denisgav/esp32_s3_weather_webserver/doc/ST7735S.png

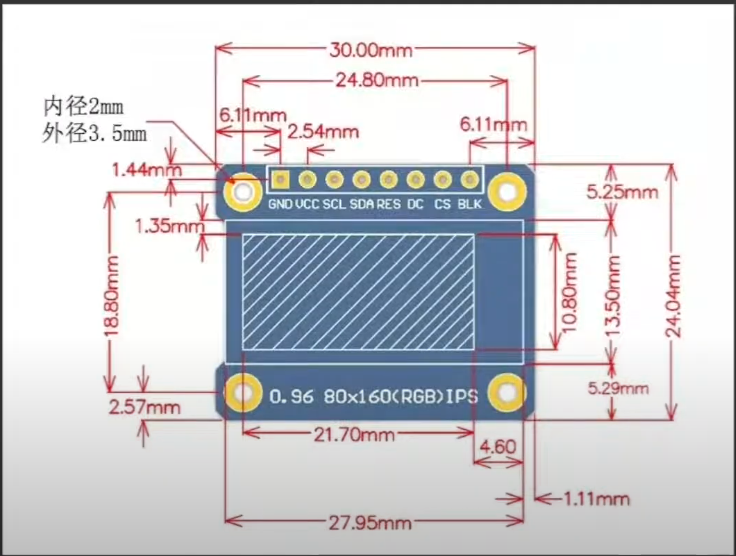
doc/ST7735S.png
