denisgav/esp32_s3_weather_webserver/doc/adafruit_products_VEML7700Q_sch.png

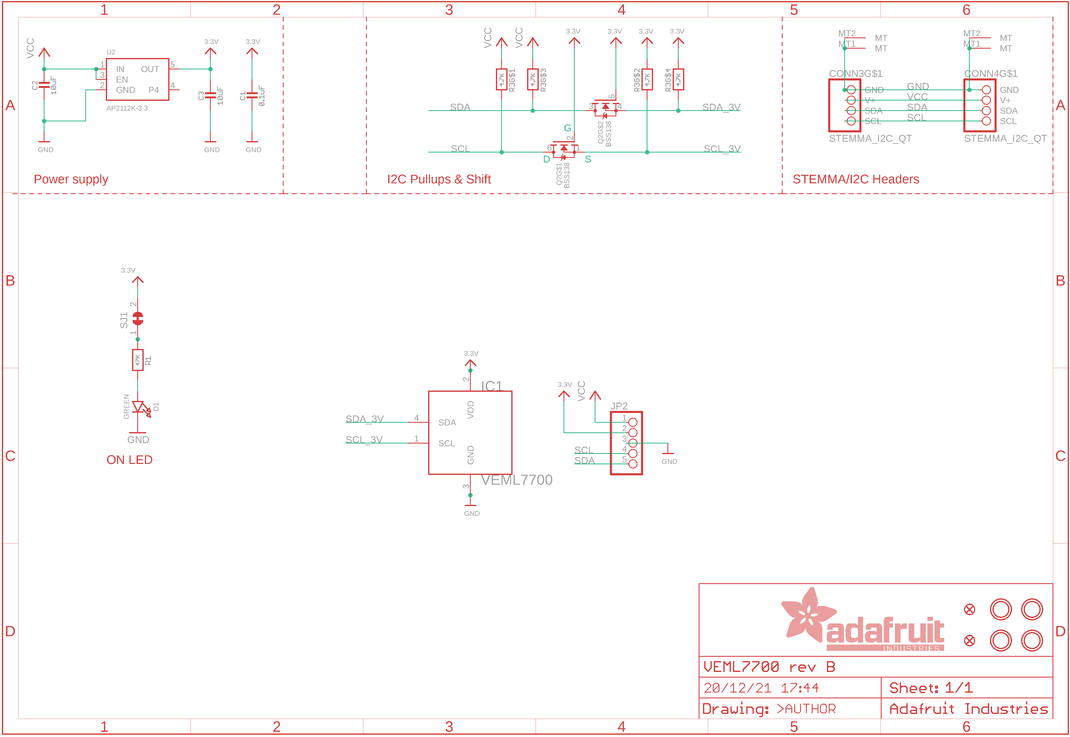
doc/adafruit_products_VEML7700Q_sch.png
