denisgav/esp32_s3_weather_webserver/doc/doc-upesy-esp32-power-path-circuit.webp

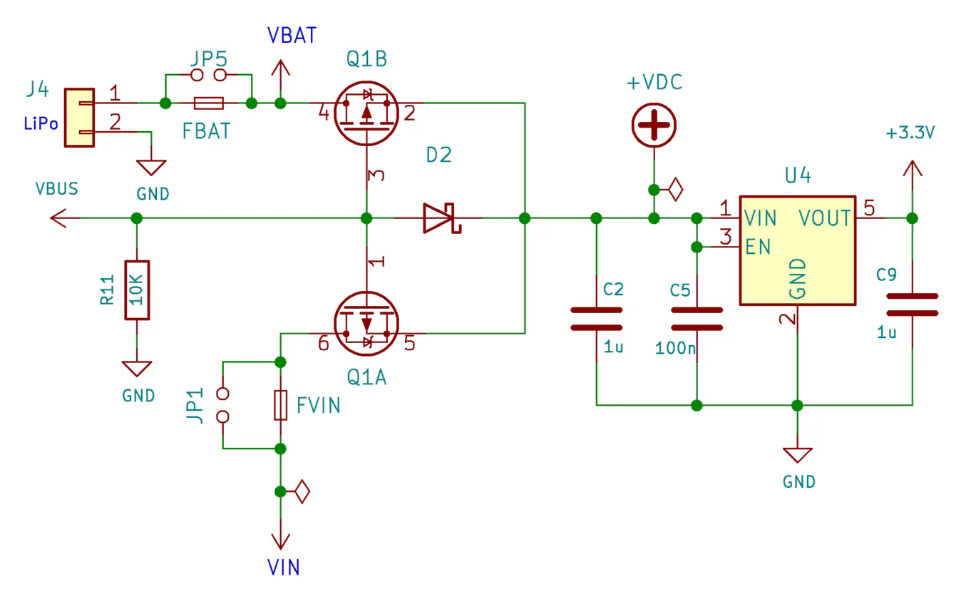
doc/doc-upesy-esp32-power-path-circuit.webp
