denisgav/esp32_s3_weather_webserver/KiCad/components/BC2032/BC2032-E2.step

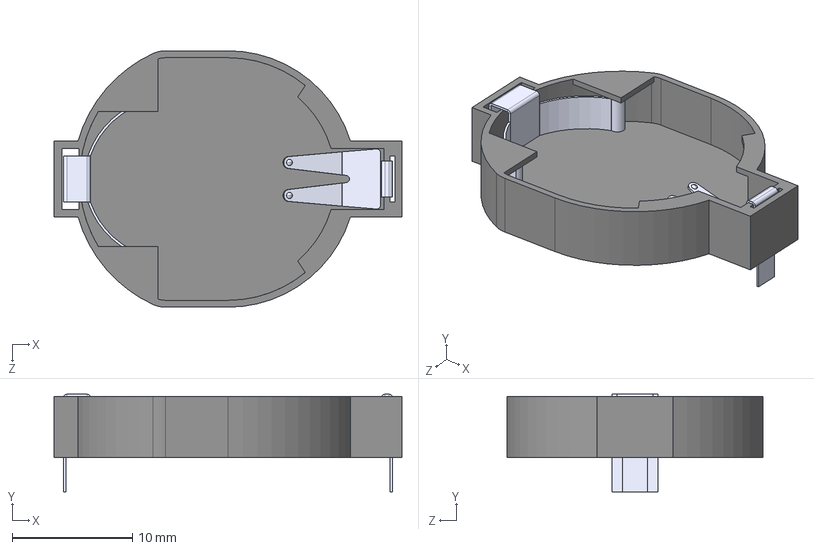
[picture p4: CAD file, 2025-09-14]
KiCad/components/BC2032/BC2032-E2.step
29.0 x 8.13 x 21.3 mm
