denisgav/esp32_s3_weather_webserver/KiCad/components/BM02B-GHS-TBT_LF__SN__N_/BM02B-GHS-TBT_LF__SN__N_.stp

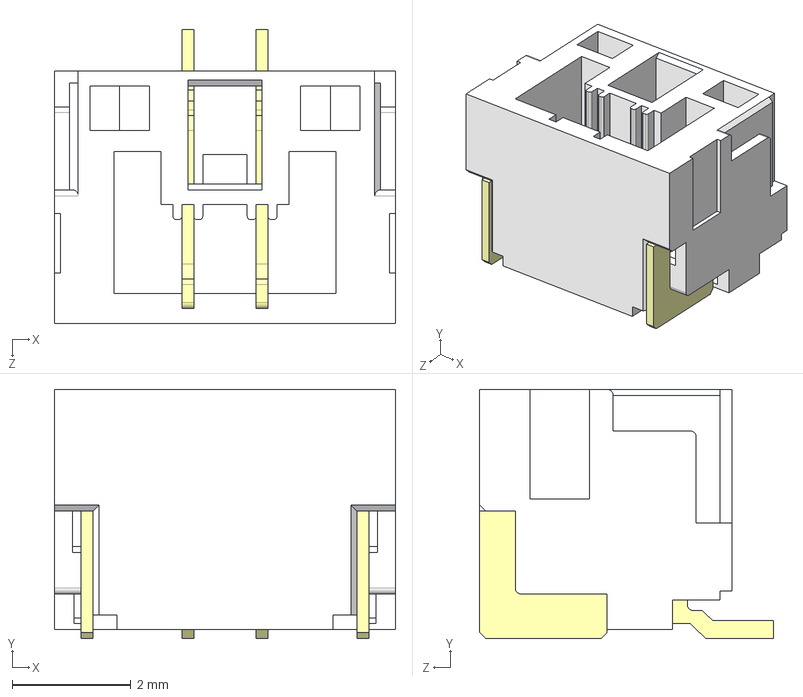
[picture p5: CAD file, 2025-09-20]
KiCad/components/BM02B-GHS-TBT_LF__SN__N_/BM02B-GHS-TBT_LF__SN__N_.stp
5.75 x 4.20 x 4.95 mm
