denisgav/esp32_s3_weather_webserver/KiCad/components/CP2102N-A02-GQFN28R/CP2102N-A02-GQFN28R.stp

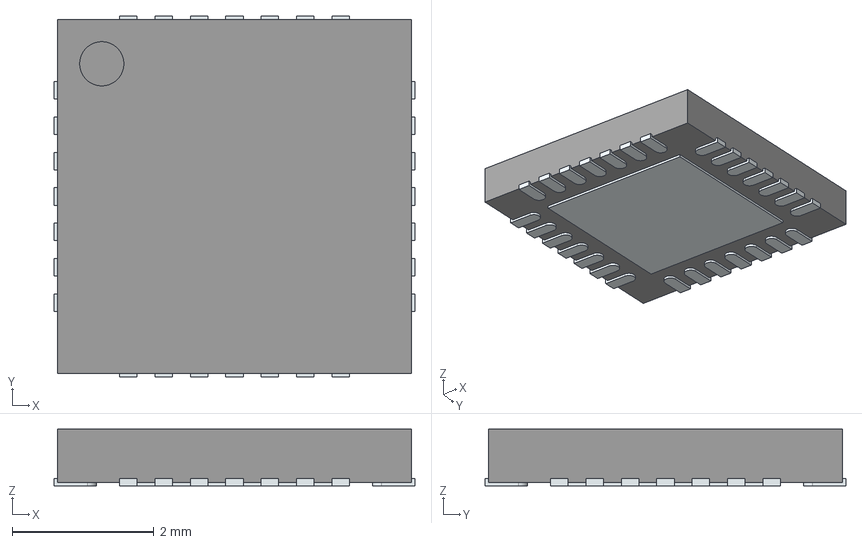
[picture p6: CAD file, 2025-09-05]
KiCad/components/CP2102N-A02-GQFN28R/CP2102N-A02-GQFN28R.stp
5.10 x 5.10 x 0.8 mm
ThermalPin
PinsArrayLR
PinsArrayTB
