denisgav/esp32_s3_weather_webserver/KiCad/components/CR1220-2/CR1220-2.stp

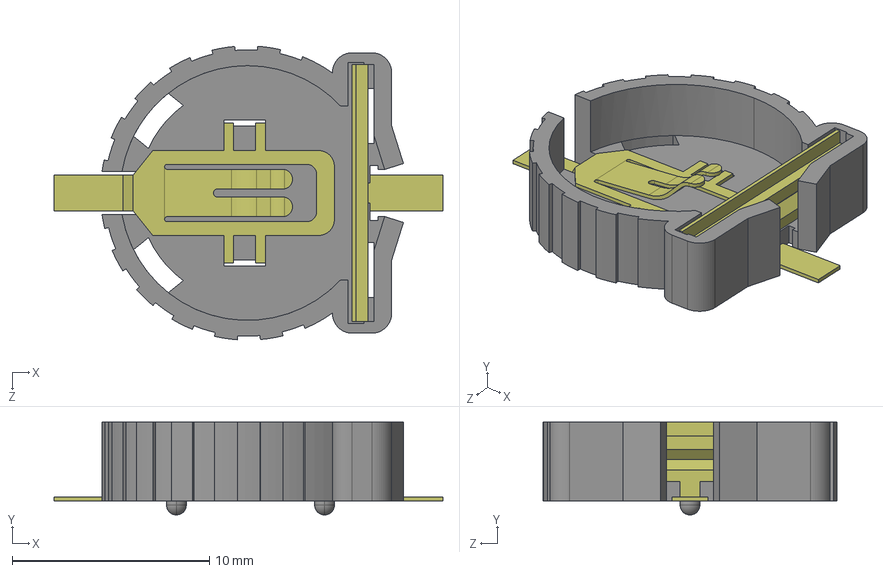
[picture p7: CAD file, 2025-09-06]
KiCad/components/CR1220-2/CR1220-2.stp
19.7 x 4.70 x 14.9 mm
