denisgav/esp32_s3_weather_webserver/KiCad/components/DS3231MZ+TRL/DS3231MZ+TRL.stp

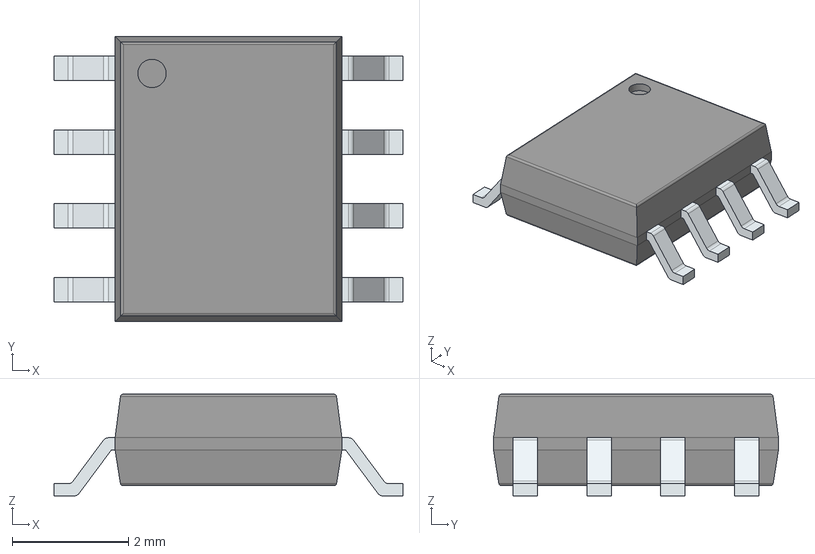
[picture p8: CAD file, 2025-09-06]
KiCad/components/DS3231MZ+TRL/DS3231MZ+TRL.stp
6.00 x 4.90 x 1.75 mm
PinsArrayLR
