denisgav/esp32_s3_weather_webserver/KiCad/components/ESP32-S3-WROOM-1-N16R8/ESP32-S3-WROOM-1-N16R8.stp

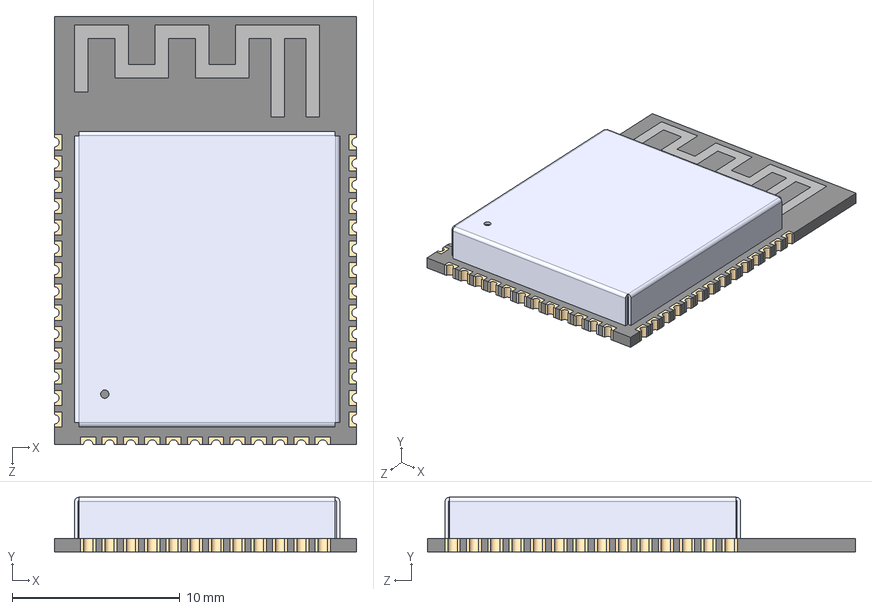
[picture p9: CAD file, 2025-09-05]
KiCad/components/ESP32-S3-WROOM-1-N16R8/ESP32-S3-WROOM-1-N16R8.stp
18.0 x 3.25 x 25.5 mm
