denisgav/esp32_s3_weather_webserver/KiCad/components/HRO  TYPE-C-31-M-12.step

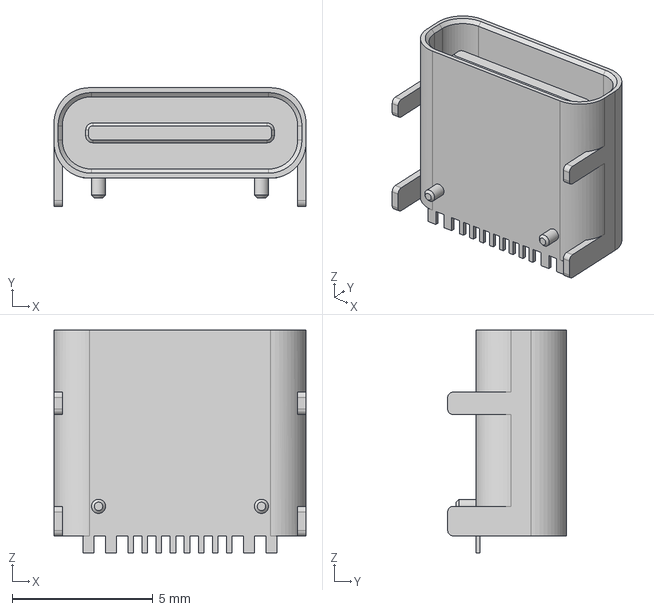
[picture p10: CAD file, 2025-09-13]
KiCad/components/HRO TYPE-C-31-M-12.step
8.94 x 4.21 x 7.90 mm
