denisgav/esp32_s3_weather_webserver/KiCad/components/SW_PUSH_6mm_H5mm/SW_PUSH_6mm_H5mm.step

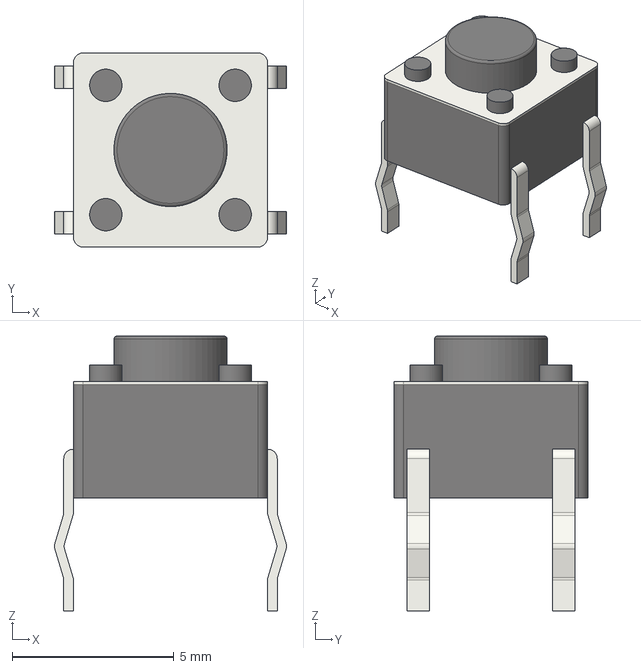
[picture p11: CAD file, 2025-09-06]
KiCad/components/SW_PUSH_6mm_H5mm/SW_PUSH_6mm_H5mm.step
7.17 x 6.00 x 8.50 mm
