denisgav/esp32_s3_weather_webserver/KiCad/components/TF-01A/TF-01A.stp

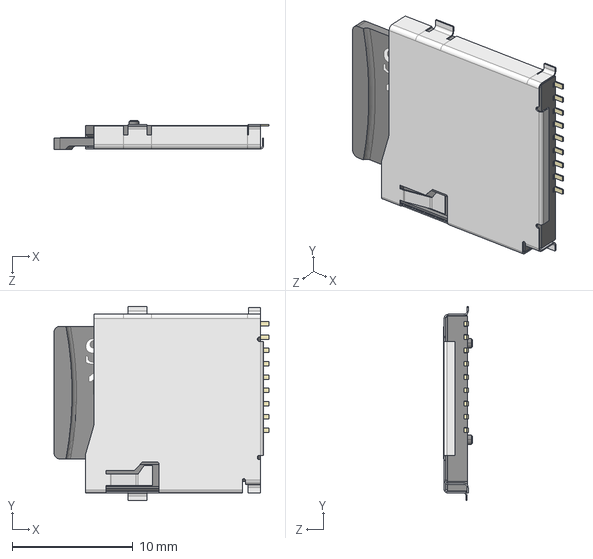
[picture p12: CAD file, 2025-09-06]
KiCad/components/TF-01A/TF-01A.stp
17.8 x 16.1 x 2.40 mm
