denisgav/esp32_s3_weather_webserver/KiCad/components/VEML7700-TT/VEML7700-TT.stp

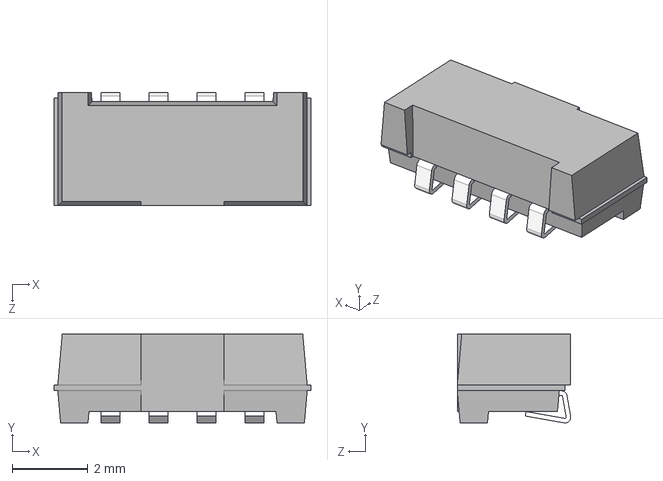
[picture p13: CAD file, 2025-09-07]
KiCad/components/VEML7700-TT/VEML7700-TT.stp
6.80 x 2.35 x 3.00 mm
