denisgav/esp32_s3_weather_webserver/KiCad/components/DHT11/DHT11.stp

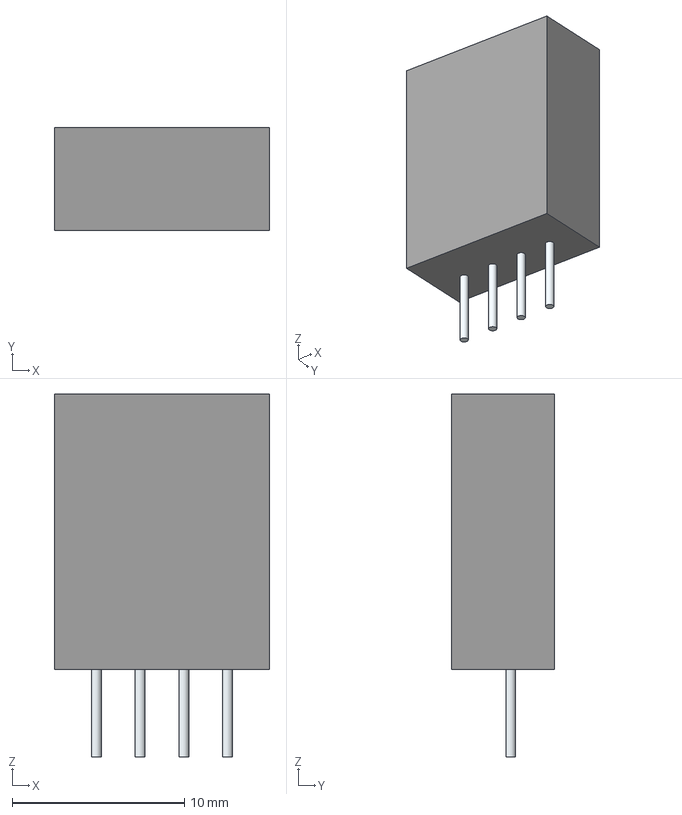
[picture p14: CAD file, 2025-09-07]
KiCad/components/DHT11/DHT11.stp
12.5 x 6.00 x 21.1 mm
Leads
