denisgav/esp32_s3_weather_webserver/KiCad/components/DHT11/101020011.stp

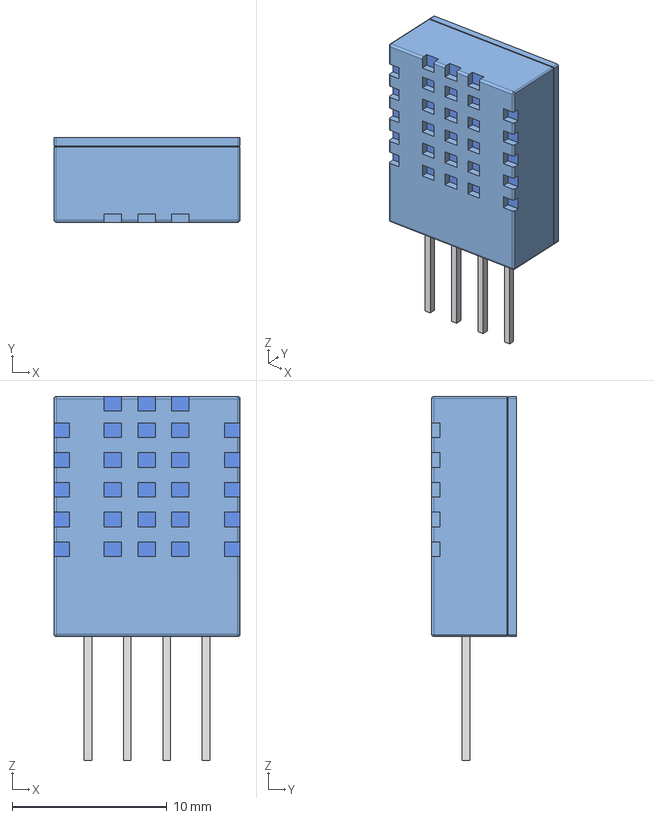
[picture p15: CAD file, 2025-09-07]
KiCad/components/DHT11/101020011.stp
12.0 x 5.50 x 23.5 mm
