denisgav/esp32_s3_weather_webserver/KiCad/components/MCP73831T-2ACI_OT/MCP73831T-2ACI_OT.stp

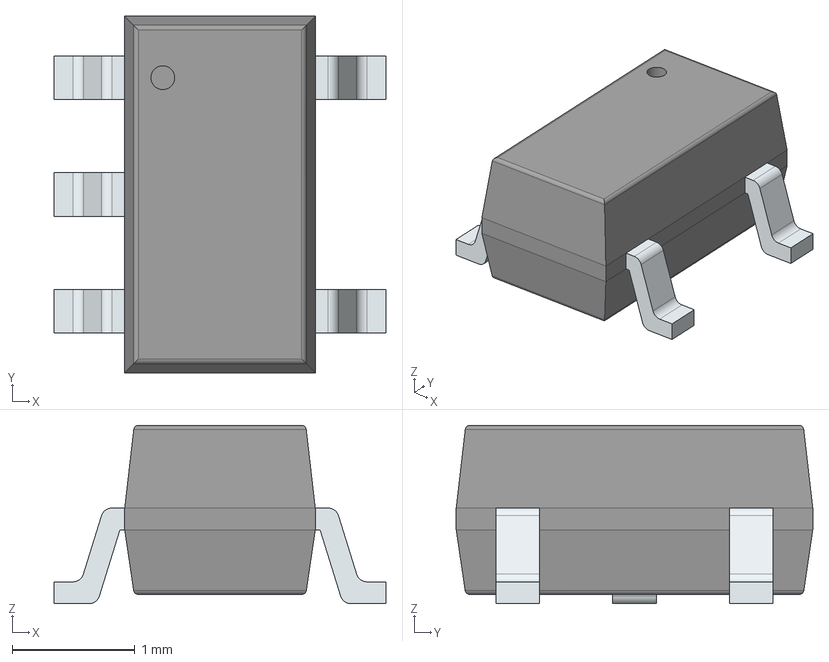
[picture p16: CAD file, 2025-09-20]
KiCad/components/MCP73831T-2ACI_OT/MCP73831T-2ACI_OT.stp
2.70 x 2.90 x 1.45 mm
PinsArrayL
PinsArrayR
