denisgav/esp32_s3_weather_webserver/KiCad/esp32_s3_weather_webserver.pdf

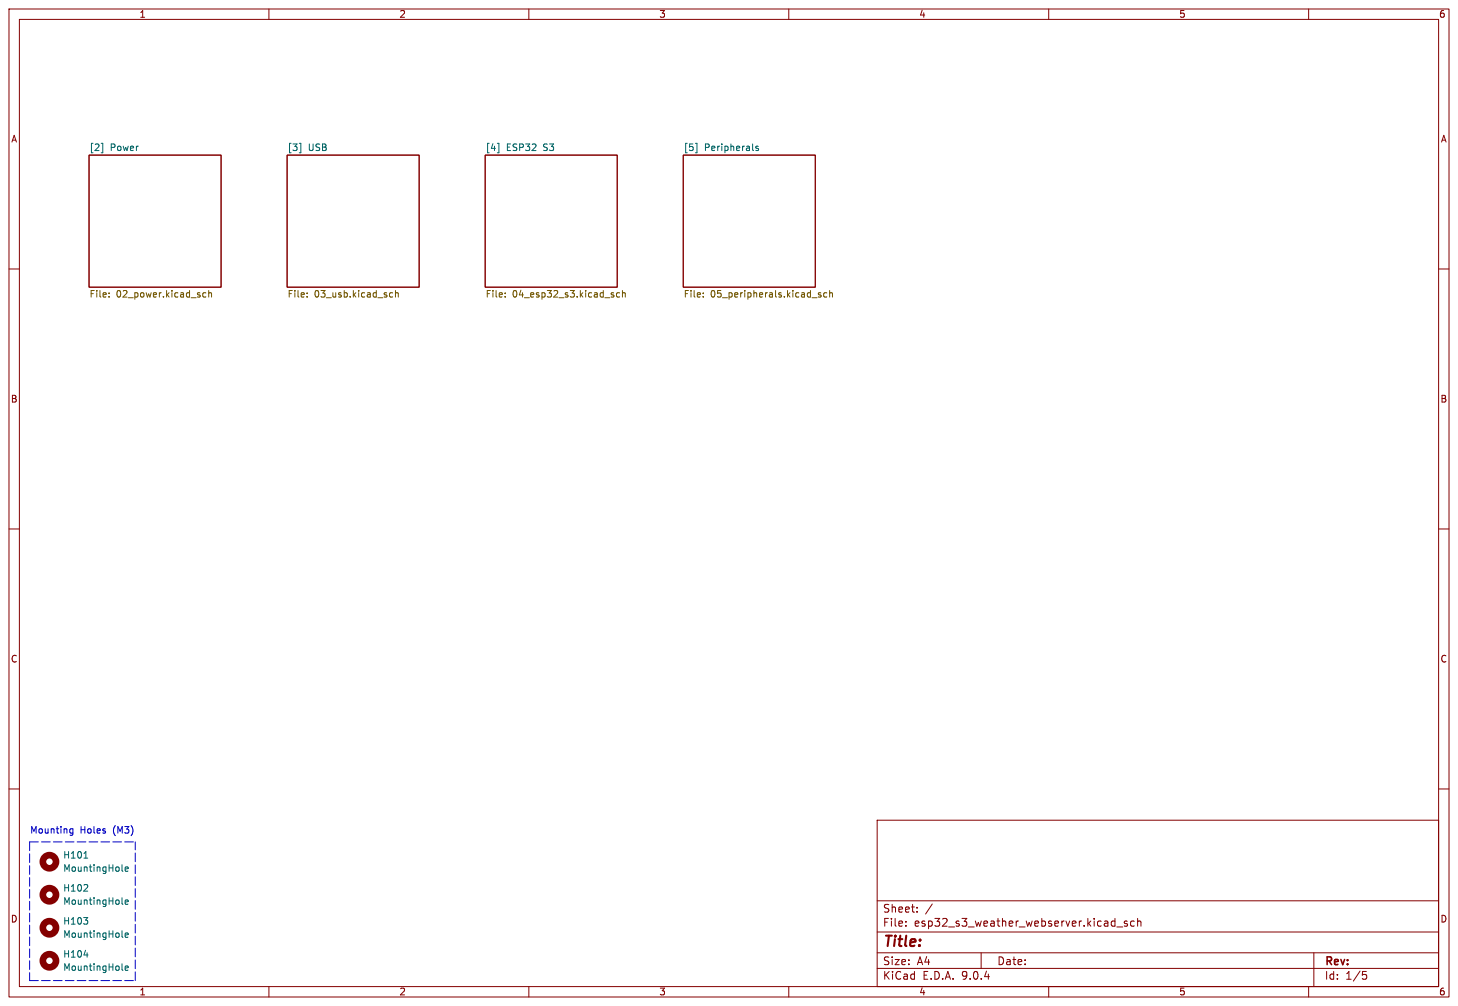
[picture p17: page 1]

[4] ESP32 S3 File: 04_esp32_s3.kicad_sch H102 MountingHole H104 MountingHole H101 MountingHole H103 MountingHole

Id: 1/5 Title: File: esp32_s3_weather_webserver.kicad_sch Sheet: /

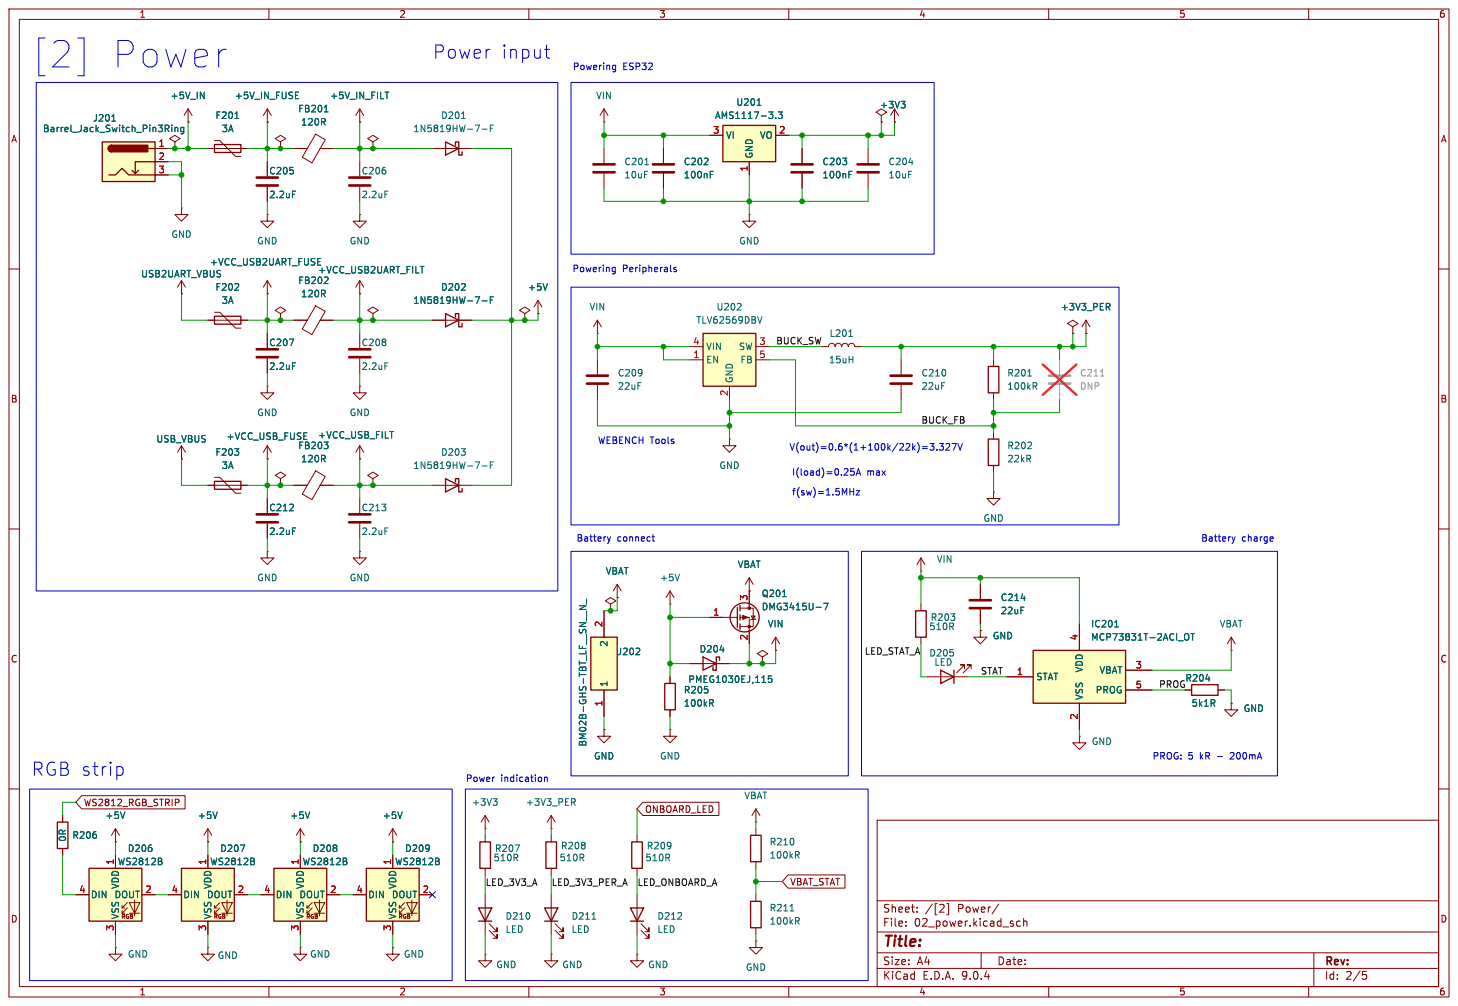
[picture p18: page 2]

100nF VIN
Battery connect Powering Peripherals

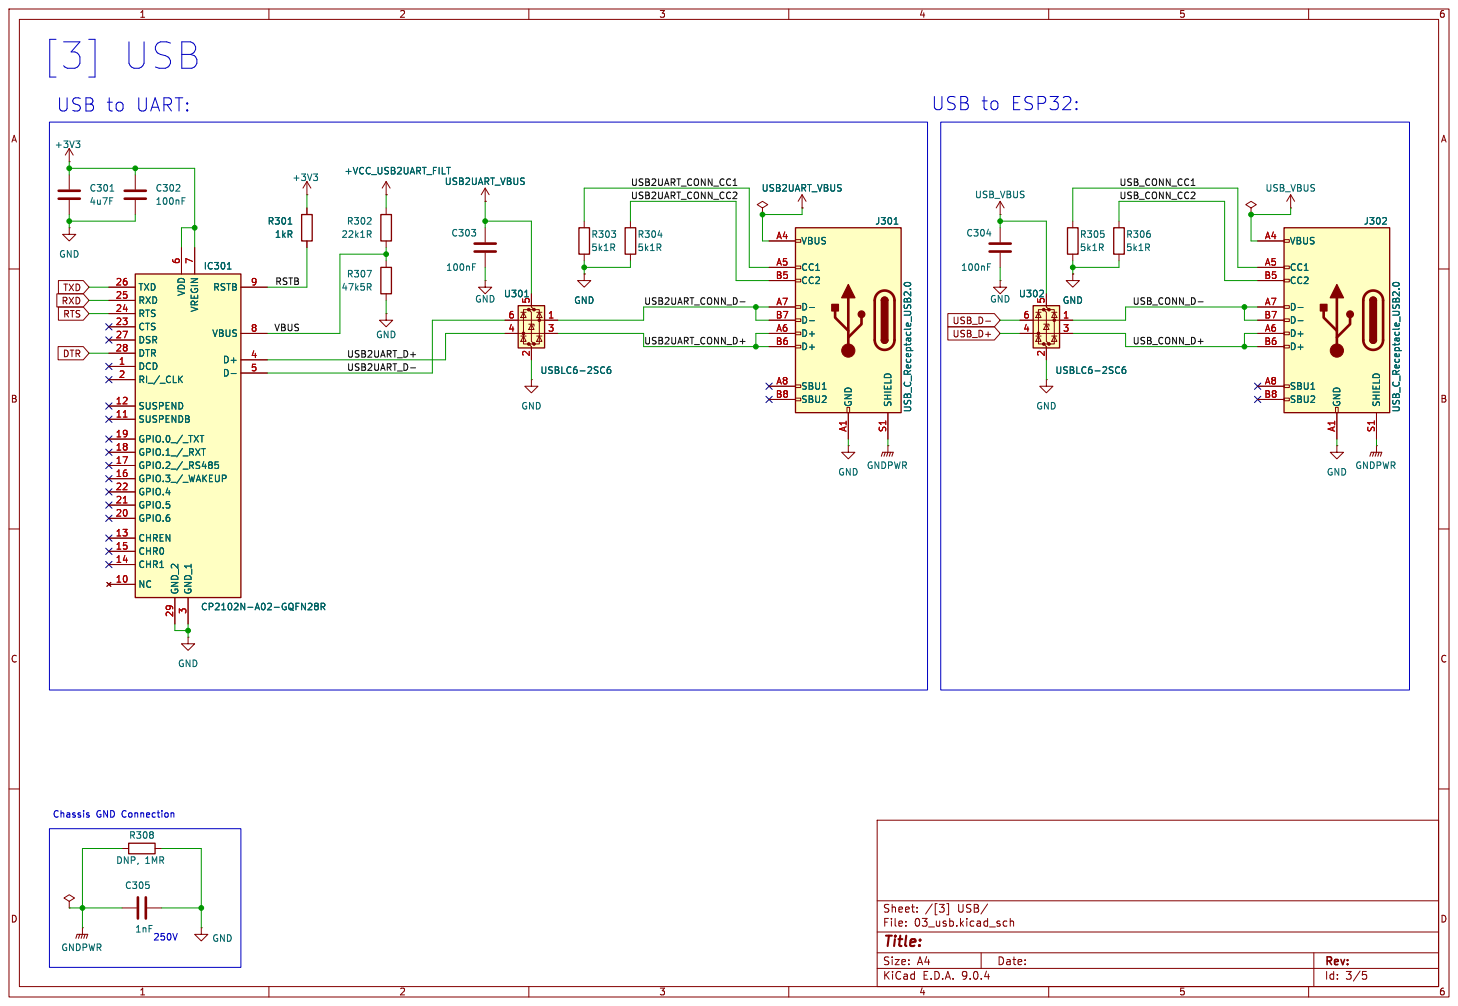
[picture p19: page 3]

6 GND_2 29 TXD 26 RXD 25 RTS 24 CTS 23 DSR 27 DTR 28 DCD 1 RI_/_CLK 2 SUSPEND 12 SUSPENDB 11 GPIO.0_/_TXT 19 GPIO.1_/_RXT 18 GPIO.2_/_RS485 17 GPIO.3_/_WAKEUP 16 GPIO.4 22 GPIO.5 21 GPIO.6 20 CHREN 13 CHR0 15 CHR1 14 NC 10 USB2UART_VBUS

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

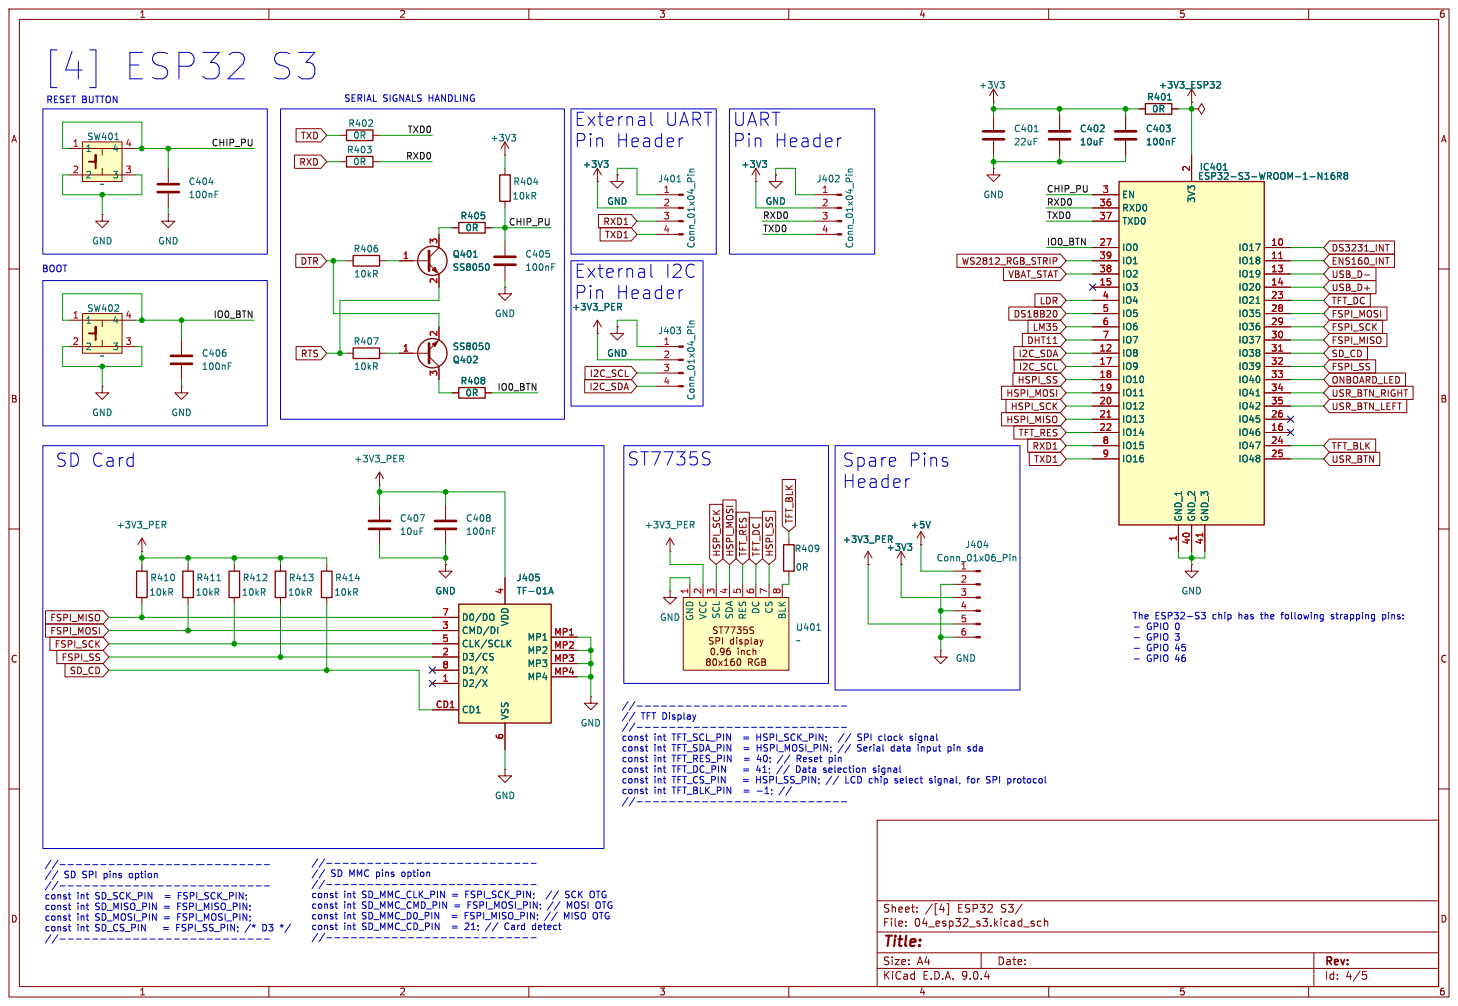
[picture p20: page 4]

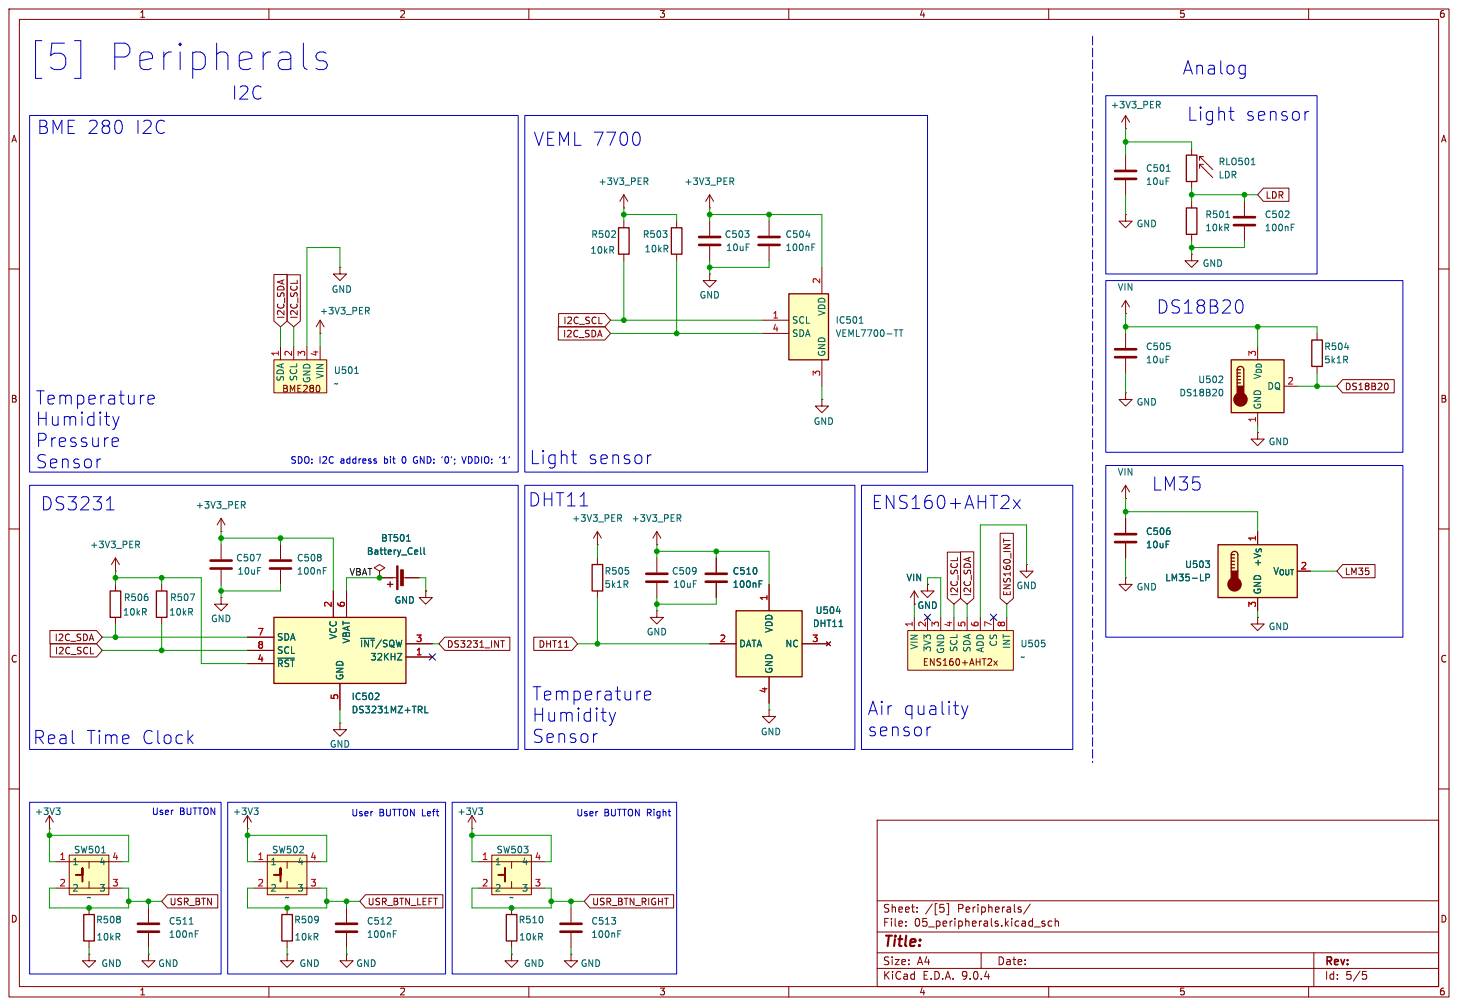
[picture p21: page 5]
