denisgav/esp32_s3_weather_webserver/KiCad/esp32_s3_weather_webserver.kicad_pcb

## KiCad design KiCad/esp32_s3_weather_webserver.kicad_pcb (2026-01-04)

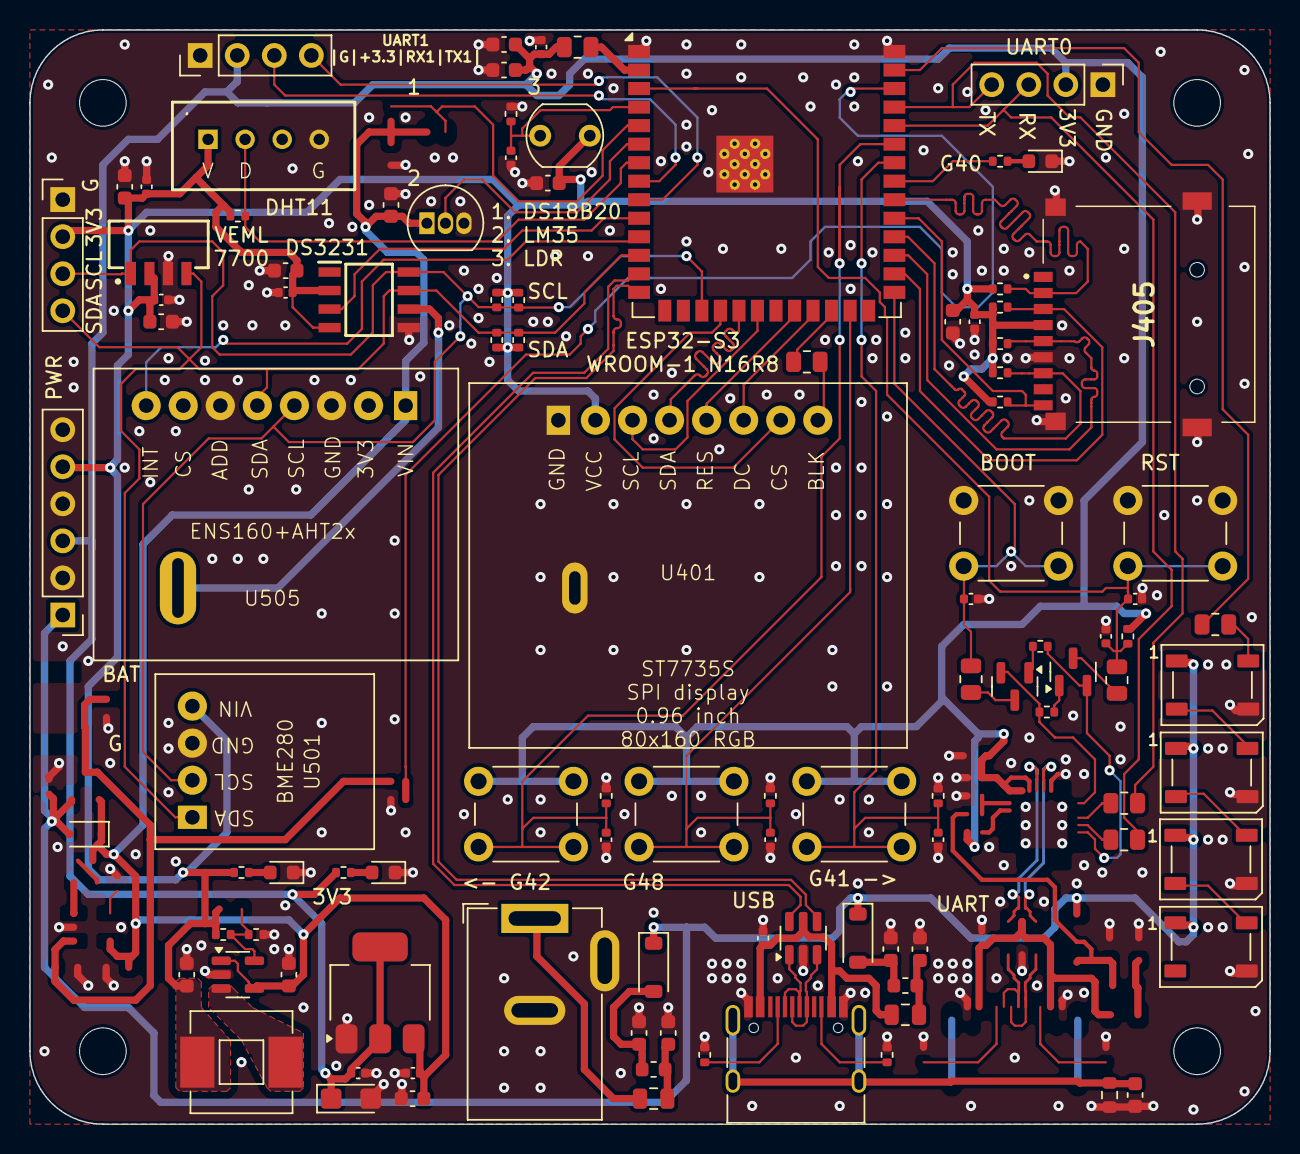
[picture p22: board esp32_s3_weather_webserver.kicad_pcb from above]

Board: 4 copper layers, 85.0 x 75.0 mm, 110 parts (1 on the bottom side), 65 nets.

Parts:
BT501: Battery_Cell; MPD_BC2032-E2
C201, C402, C407, C501, C503, C506, C507, C509: 10uF; C_0603_1608Metric
C202, C203, C304, C403, C404, C405, C406, C408, C502, C504, C508, C510, C511, C512, C513: 100nF; C_0402_1005Metric
C204: 22uF_P; CP_EIA-3216-18_Kemet-A
C205, C206, C212, C213: 2.2uF; C_0603_1608Metric
C209, C210, C401: 22uF; C_0603_1608Metric
C305: 1nF; C_0603_1608Metric
D201, D203: 1N5819HW-7-F; D_SOD-123
D204: PMEG1030EJ,115; D_SOD-323F
D206, D207, D208, D209: WS2812B; LED_WS2812B_PLCC4_5.0x5.0mm_P3.2mm
D210, D211, D212: LED; LED_0603_1608Metric
F201, F203: 3A; Fuse_0805_2012Metric
FB201, FB203: 120R; Fuse_0603_1608Metric
H101, H102, H103, H104: MountingHole; MountingHole_3.2mm_M3
IC401: ESP32-S3-WROOM-1-N16R8; ESP32S3WROOM1N16R8
IC501: VEML7700-TT; VEML7700
IC502: DS3231MZ+TRL; SOIC127P600X175-8N
J201: Barrel_Jack_Switch_Pin3Ring; BarrelJack_GCT_DCJ200-10-A_Horizontal
J302: USB_C_Receptacle_USB2.0; USB_C_Receptacle_HRO_TYPE-C-31-M-12
J401, J402, J403: Conn_01x04_Pin; PinHeader_1x04_P2.54mm_Vertical
J404: Conn_01x06_Pin; PinHeader_1x06_P2.54mm_Vertical
J405: TF-01A; TF01A
L201: 15uH; MWSA0603S
Q401, Q402: SS8050; SOT-23
R201: 100kR; R_0402_1005Metric
R202: 22kR; R_0402_1005Metric
R206, R401, R402, R403, R405, R408, R409: 0R; R_0805_2012Metric
R207, R208, R209: 510R; R_0402_1005Metric
R305, R306, R505: 5k1R; R_0402_1005Metric
R308: DNP, 1MR; R_0603_1608Metric
R404, R406, R407, R410, R411, R412, R413, R414, R501, R502, R503, R506, R507, R508, R509, R510: 10kR; R_0402_1005Metric
RLO501: LDR; R_LDR_5.1x4.3mm_P3.4mm_Vertical
SW401, SW402, SW501, SW502, SW503: SW_PUSH_6mm_H5mm
U201: AMS1117-3.3; SOT-223-3_TabPin2
U202: TLV62569DBV; SOT-23-5
U302: USBLC6-2SC6; SOT-23-6
U401: ST7735S
U501: BME280
U503: LM35-LP; TO-92_Inline
U504: DHT11
U505: ENS160+AHT2x

Connections:
+3V3: C203.1, C204.1, C401.1, C402.1, C403.1, J401.2, J402.2, J404.3, R207.2, R401.1, R404.2, SW501.1, SW501.4, SW502.1, SW502.4, SW503.1, SW503.4, U201.2 (VO)
+3V3_ESP32: IC401.2 (3V3), R401.2
+3V3_PER: C210.1, C407.1, C408.1, C501.1, C503.1, C504.1, C507.1, C508.1, C509.1, C510.1, IC501.2 (VDD), IC502.2 (VCC), IC502.4 (~RST), J403.2, J404.5, J405.4 (VDD), L201.2, R201.2, R208.2, R410.2, R411.2, R412.2, R413.2, R414.2, R502.2, R503.2, R505.1, R506.2, R507.2, RLO501.2, U401.2 (VCC), U501.4 (VIN), U504.1 (VDD)
+5V: D201.1 (K), D203.1 (K), D204.2 (A), D206.1 (VDD), D207.1 (VDD), D208.1 (VDD), D209.1 (VDD), J404.1
+5V_IN: F201.1, J201.1
+5V_IN_FILT: C206.1, D201.2 (A), FB201.1
+5V_IN_FUSE: C205.1, F201.2, FB201.2
+VCC_USB_FILT: C213.1, D203.2 (A), FB203.1
+VCC_USB_FUSE: C212.1, F203.2, FB203.2
/[2] Power/BUCK_FB: R201.1, R202.2, U202.5 (FB)
/[2] Power/BUCK_SW: L201.1, U202.3 (SW)
/[2] Power/LED_3V3_A: D210.2 (A), R207.1
/[2] Power/LED_3V3_PER_A: D211.2 (A), R208.1
/[2] Power/LED_ONBOARD_A: D212.2 (A), R209.1
/[3] USB/USB_CONN_CC1: J302.A5 (CC1), R305.1
/[3] USB/USB_CONN_CC2: J302.B5 (CC2), R306.1
/[3] USB/USB_CONN_D+: J302.A6 (D+), J302.B6 (D+), U302.3 (I/O2)
/[3] USB/USB_CONN_D-: J302.A7 (D-), J302.B7 (D-), U302.1 (I/O1)
/[4] ESP32 S3/CHIP_PU: C404.1, C405.1, IC401.3 (EN), R404.1, R405.2, SW401.1, SW401.4
/[4] ESP32 S3/IO0_BTN: C406.1, IC401.27 (IO0), R408.2, SW402.1, SW402.4
/[4] ESP32 S3/RXD0: IC401.36 (RXD0), J402.3, R403.2
/[4] ESP32 S3/TXD0: IC401.37 (TXD0), J402.4, R402.2
/[5] Peripherals/VBAT: BT501.1 (+), IC502.6 (VBAT)
DHT11: IC401.7 (IO7), R505.2, U504.2 (DATA)
DS3231_INT: IC401.10 (IO17), IC502.3 (~INT/SQW)
DTR: Q402.2 (E), R406.1
ENS160_INT: IC401.11 (IO18), U505.8 (INT)
FSPI_MISO: IC401.30 (IO37), J405.7 (D0/DO), R410.1
FSPI_MOSI: IC401.28 (IO35), J405.3 (CMD/DI), R411.1
FSPI_SCK: IC401.29 (IO36), J405.5 (CLK/SCLK), R412.1
FSPI_SS: IC401.32 (IO39), J405.2 (D3/CS), R413.1
GND: BT501.2 (-), C201.2, C202.2, C203.2, C204.2, C205.2, C206.2, C209.2, C210.2, C212.2, C213.2, C304.2, C305.2, C401.2, C402.2, C403.2, C404.2, C405.2, C406.2, C407.2, C408.2, C501.2, C502.2, C503.2, C504.2, C506.2, C507.2, C508.2, C509.2, C510.2, C511.2, C512.2, C513.2, D206.3 (VSS), D207.3 (VSS), D208.3 (VSS), D209.3 (VSS), D210.1 (K), D211.1 (K), D212.1 (K), IC401.1 (GND_1), IC401.40 (GND_2), IC401.41 (GND_3), IC501.3 (GND), IC502.5 (GND), J201.2, J201.3, J302.A1 (GND), J302.A12 (GND), J302.B1 (GND), J302.B12 (GND), J401.1, J402.1, J403.1, J404.2, J404.4, J404.6, J405.6 (VSS), J405.MP1, J405.MP2, J405.MP3, J405.MP4, R202.1, R305.2, R306.2, R308.2, R501.2, R508.1, R509.1, R510.1, SW401.2, SW401.3, SW402.2, SW402.3, U201.1 (GND), U202.2 (GND), U302.2 (GND), U401.1 (GND), U501.3 (GND), U503.3 (GND), U504.4 (GND), U505.3 (GND), U505.6 (ADD)
GNDPWR: C305.1, J302.S1 (SHIELD), R308.1
HSPI_MOSI: IC401.19 (IO11), U401.4 (SDA)
HSPI_SCK: IC401.20 (IO12), U401.3 (SCL)
HSPI_SS: IC401.18 (IO10), U401.7 (CS)
I2C_SCL: IC401.17 (IO9), IC501.1 (SCL), IC502.8 (SCL), J403.3, R502.1, R507.1, U501.2 (SCL), U505.4 (SCL)
I2C_SDA: IC401.12 (IO8), IC501.4 (SDA), IC502.7 (SDA), J403.4, R503.1, R506.1, U501.1 (SDA), U505.5 (SDA)
LDR: C502.1, IC401.4 (IO4), R501.1, RLO501.1
LM35: IC401.6 (IO6), U503.2 (V_{OUT})
unnamed: D206.4 (DIN), R206.1
unnamed: D206.2 (DOUT), D207.4 (DIN)
unnamed: D207.2 (DOUT), D208.4 (DIN)
unnamed: D208.2 (DOUT), D209.4 (DIN)
unnamed: Q401.1 (B), R406.2
unnamed: Q401.3 (C), R405.1
unnamed: Q402.1 (B), R407.2
unnamed: Q402.3 (C), R408.1
unnamed: R409.1, U401.8 (BLK)
ONBOARD_LED: IC401.33 (IO40), R209.2
RTS: Q401.2 (E), R407.1
RXD1: IC401.8 (IO15), J401.3
SD_CD: IC401.31 (IO38), J405.CD1, R414.1
TFT_BLK: IC401.24 (IO47), R409.2
TFT_DC: IC401.23 (IO21), U401.6 (DC)
TFT_RES: IC401.22 (IO14), U401.5 (RES)
TXD1: IC401.9 (IO16), J401.4
USB_D+: IC401.14 (IO20), U302.4 (I/O2)
USB_D-: IC401.13 (IO19), U302.6 (I/O1)
USB_VBUS: C304.1, F203.1, J302.A4 (VBUS), J302.A9 (VBUS), J302.B4 (VBUS), J302.B9 (VBUS), U302.5 (VBUS)
USR_BTN: C511.1, IC401.25 (IO48), R508.2, SW501.2, SW501.3
USR_BTN_LEFT: C512.1, IC401.35 (IO42), R509.2, SW502.2, SW502.3
USR_BTN_RIGHT: C513.1, IC401.34 (IO41), R510.2, SW503.2, SW503.3
VIN: C201.1, C202.1, C209.1, C506.1, D204.1 (K), U201.3 (VI), U202.1 (EN), U202.4 (VIN), U503.1 (+V_{S}), U505.1 (VIN)
WS2812_RGB_STRIP: IC401.39 (IO1), R206.2
