denisgav/esp32_s3_weather_webserver/Firmware/src/multisensor_wrapper.h

#pragma once

#include <Arduino.h>

#include "board_defines.h"

//-------------------------------------------------
// DS3231
//-------------------------------------------------
#include "DS3231_wrapper.h"
//-------------------------------------------------

//-------------------------------------------------
// BME280
//-------------------------------------------------
#include "BME280_wrapper.h"
//-------------------------------------------------

//-------------------------------------------------
// ENS160
//-------------------------------------------------
#include "ENS160_wrapper.h"
//-------------------------------------------------

//-------------------------------------------------
// AHT2x
//-------------------------------------------------
#include "AHT2x_wrapper.h"
//-------------------------------------------------

//-------------------------------------------------
// VEML7700
//-------------------------------------------------
#include "VEML7700_wrapper.h"
//-------------------------------------------------

//-------------------------------------------------
// DHT11
//-------------------------------------------------
#include "DHT11_wrapper.h"
//-------------------------------------------------

//-------------------------------------------------
// LM35
//-------------------------------------------------
#include "LM35_wrapper.h"
//-------------------------------------------------

//-------------------------------------------------
// DS18B20
//-------------------------------------------------
#include "DS18B20_wrapper.h"
//-------------------------------------------------

//-------------------------------------------------
// LDR
//-------------------------------------------------
#include "LDR_wrapper.h"
//-------------------------------------------------


class multisensor_wrapper{
public:
    // Class constructor
    multisensor_wrapper();
    // Initialize BME sensor
    bool init();
    // Sample date/time
    bool sample_sensor_data();

    // RTC3231
    DS3231_wrapper& get_rtc();
    // BME280
    BME280_wrapper& get_bme280();
    // ENS160
    ENS160_wrapper& get_ens160();
    // AHT2x
    AHT2x_wrapper& get_aht2x();
    // VEML7700
    VEML7700_wrapper& get_veml7700();
    // DHT11
    DHT11_wrapper& get_dht11();
    // LM35
    LM35_wrapper& get_lm35();
    // DS18B20
    DS18B20_wrapper& get_ds18b20();
    // LDR
    LDR_wrapper& get_ldr();

    // Print sampled values to serial
    void print_to_serial() const;

    bool get_is_initialized() const;
private:
    // RTC3231
    DS3231_wrapper rtc;

    // BME280
    BME280_wrapper bme280;

    // ENS160
    ENS160_wrapper ens160;

    // AHT2x
    AHT2x_wrapper aht2x;

    // VEML7700
    VEML7700_wrapper veml7700;

    // DHT11
    DHT11_wrapper dht11;

    // LM35
    LM35_wrapper lm35;

    // DS18B20
    DS18B20_wrapper ds18b20;

    // LDR
    LDR_wrapper ldr;
    
    bool is_initialized;
};
