denisgav/esp32_s3_weather_webserver/(commit log)

2025-08-30 Non operational web server
    [huge_app.csv.csv]
2025-09-05 Add KiCad project
    [ESP32-S3-WROOM-1-N16R8.stp, esp32_s3_weather_webserver.kicad_pcb, esp32_s3_weather_webserver.kicad_sch, huge_app.csv.csv]
2025-09-05 USB scheme
    [02_power.kicad_sch, 03_usb.kicad_sch, 04_esp32_s3.kicad_sch, 05_peripherals.kicad_sch, CP2102N-A02-GQFN28R.stp, esp32_s3_weather_webserver.kicad_sch]
2025-09-05 Update power scheme
    [02_power.kicad_sch, 04_esp32_s3.kicad_sch]
2025-09-06 Update ESP32 Scheme
    [04_esp32_s3.kicad_sch, SW_PUSH_6mm_H5mm.step]
2025-09-06 Add SD card to scheme
    [04_esp32_s3.kicad_sch, 05_peripherals.kicad_sch, TF-01A.stp]
2025-09-06 Add BME280
    [05_peripherals.kicad_sch]
2025-09-06 Add DS3231
    [03_usb.kicad_sch, 04_esp32_s3.kicad_sch, 05_peripherals.kicad_sch, CR1220-2.stp, DS3231MZ+TRL.stp]
2025-09-06 Add analog sensors
    [02_power.kicad_sch, 03_usb.kicad_sch, 04_esp32_s3.kicad_sch, 05_peripherals.kicad_sch]
2025-09-07 First scheme version
    [02_power.kicad_sch, 03_usb.kicad_sch, 04_esp32_s3.kicad_sch, 05_peripherals.kicad_sch, 101020011.stp, DHT11.stp, VEML7700-TT.stp]
2025-09-08 Firmware refactoring. Beginning
    [02_power.kicad_sch, 04_esp32_s3.kicad_sch, 05_peripherals.kicad_sch, esp32_s3_weather_webserver.kicad_pcb]
2025-09-09 Update BME280 Scheme, Add more sensors to firmware
    [04_esp32_s3.kicad_sch, 05_peripherals.kicad_sch]
2025-09-09 Add UART pin header
    [03_usb.kicad_sch, 04_esp32_s3.kicad_sch]
2025-09-09 Add multisensor wrapper
    [05_peripherals.kicad_sch, esp32_s3_weather_webserver.kicad_pcb]
2025-09-10 all sensors on web page
2025-09-11 Remove 3V3A power chain
    [02_power.kicad_sch, 05_peripherals.kicad_sch]
2025-09-11 Add sensor footprints
    [04_esp32_s3.kicad_sch, 05_peripherals.kicad_sch, esp32_s3_weather_webserver.kicad_pcb]
2025-09-11 BOM updates
    [02_power.kicad_sch, 03_usb.kicad_sch, 04_esp32_s3.kicad_sch, 05_peripherals.kicad_sch, esp32_s3_weather_webserver.kicad_pcb, esp32_s3_weather_webserver.kicad_sch]
2025-09-12 BOM updates. First layout
    [02_power.kicad_sch, 03_usb.kicad_sch, 04_esp32_s3.kicad_sch, 05_peripherals.kicad_sch, esp32_s3_weather_webserver.kicad_pcb, esp32_s3_weather_webserver.kicad_sch]
2025-09-12 Layout updates
    [05_peripherals.kicad_sch, esp32_s3_weather_webserver.kicad_pcb]
2025-09-13 PCB layout updates
    [04_esp32_s3.kicad_sch, esp32_s3_weather_webserver.kicad_pcb]
2025-09-13 PCB layout improvements
    [HRO TYPE-C-31-M-12.step, esp32_s3_weather_webserver.kicad_pcb]
2025-09-14 Simple routing
    [04_esp32_s3.kicad_sch, esp32_s3_weather_webserver.kicad_pcb]
2025-09-14 SPI signals routing
    [04_esp32_s3.kicad_sch, 05_peripherals.kicad_sch, BC2032-E2.step, esp32_s3_weather_webserver.kicad_pcb]
2025-09-15 Simple signal routing
    [04_esp32_s3.kicad_sch, esp32_s3_weather_webserver.kicad_pcb]
2025-09-16 Signals routing
    [esp32_s3_weather_webserver.kicad_pcb]
2025-09-16 Signal routing
    [05_peripherals.kicad_sch, esp32_s3_weather_webserver.kicad_pcb]
2025-09-16 Fix USB signal routing
    [esp32_s3_weather_webserver.kicad_pcb]
2025-09-18 Fix DRC
    [04_esp32_s3.kicad_sch, esp32_s3_weather_webserver.kicad_pcb]
2025-09-18 Temperature sensor placement update
    [esp32_s3_weather_webserver.kicad_pcb]
2025-09-18 Silk Screen updates
    [esp32_s3_weather_webserver.kicad_pcb]
2025-09-18 Update pin defines
2025-09-20 Add battery connector and charger
    [02_power.kicad_sch, 04_esp32_s3.kicad_sch, 05_peripherals.kicad_sch, BM02B-GHS-TBT_LF__SN__N_.stp, MCP73831T-2ACI_OT.stp, esp32_s3_weather_webserver.kicad_pcb]
2025-09-20 Connect VBAT to ADC input to measure battery voltage
    [02_power.kicad_sch, 04_esp32_s3.kicad_sch, esp32_s3_weather_webserver.kicad_pcb]
2025-09-20 Use tantalum capacitor with AMS. Add basic output to TFT.
    [02_power.kicad_sch, esp32_s3_weather_webserver.kicad_pcb]
2025-09-20 VBAT decoupling capacitor
    [02_power.kicad_sch, esp32_s3_weather_webserver.kicad_pcb]
2025-09-21 Production files prepare
    [02_power.kicad_sch, 05_peripherals.kicad_sch, bom.csv, designators.csv, esp32_s3_weather_webserver.kicad_pcb, positions.csv]
2025-09-21 Update BOM file
    [esp32_s3_weather_webserver__BOM.csv, esp32_s3_weather_webserver__BOM_2.csv]
2026-01-04 Remove broken scheme parts
    [02_power.kicad_sch, 03_usb.kicad_sch, 04_esp32_s3.kicad_sch, 05_peripherals.kicad_sch, bom.csv, esp32_s3_weather_webserver.kicad_pcb, esp32_s3_weather_webserver__BOM.csv, positions.csv]
